wAISw/dao-choc-ble/pcb/56key/dao-choc-ble-pcb-right/dao-choc-ble-right.kicad_pcb

## KiCad design pcb/56key/dao-choc-ble-pcb-right/dao-choc-ble-right.kicad_pcb (2022-12-07)

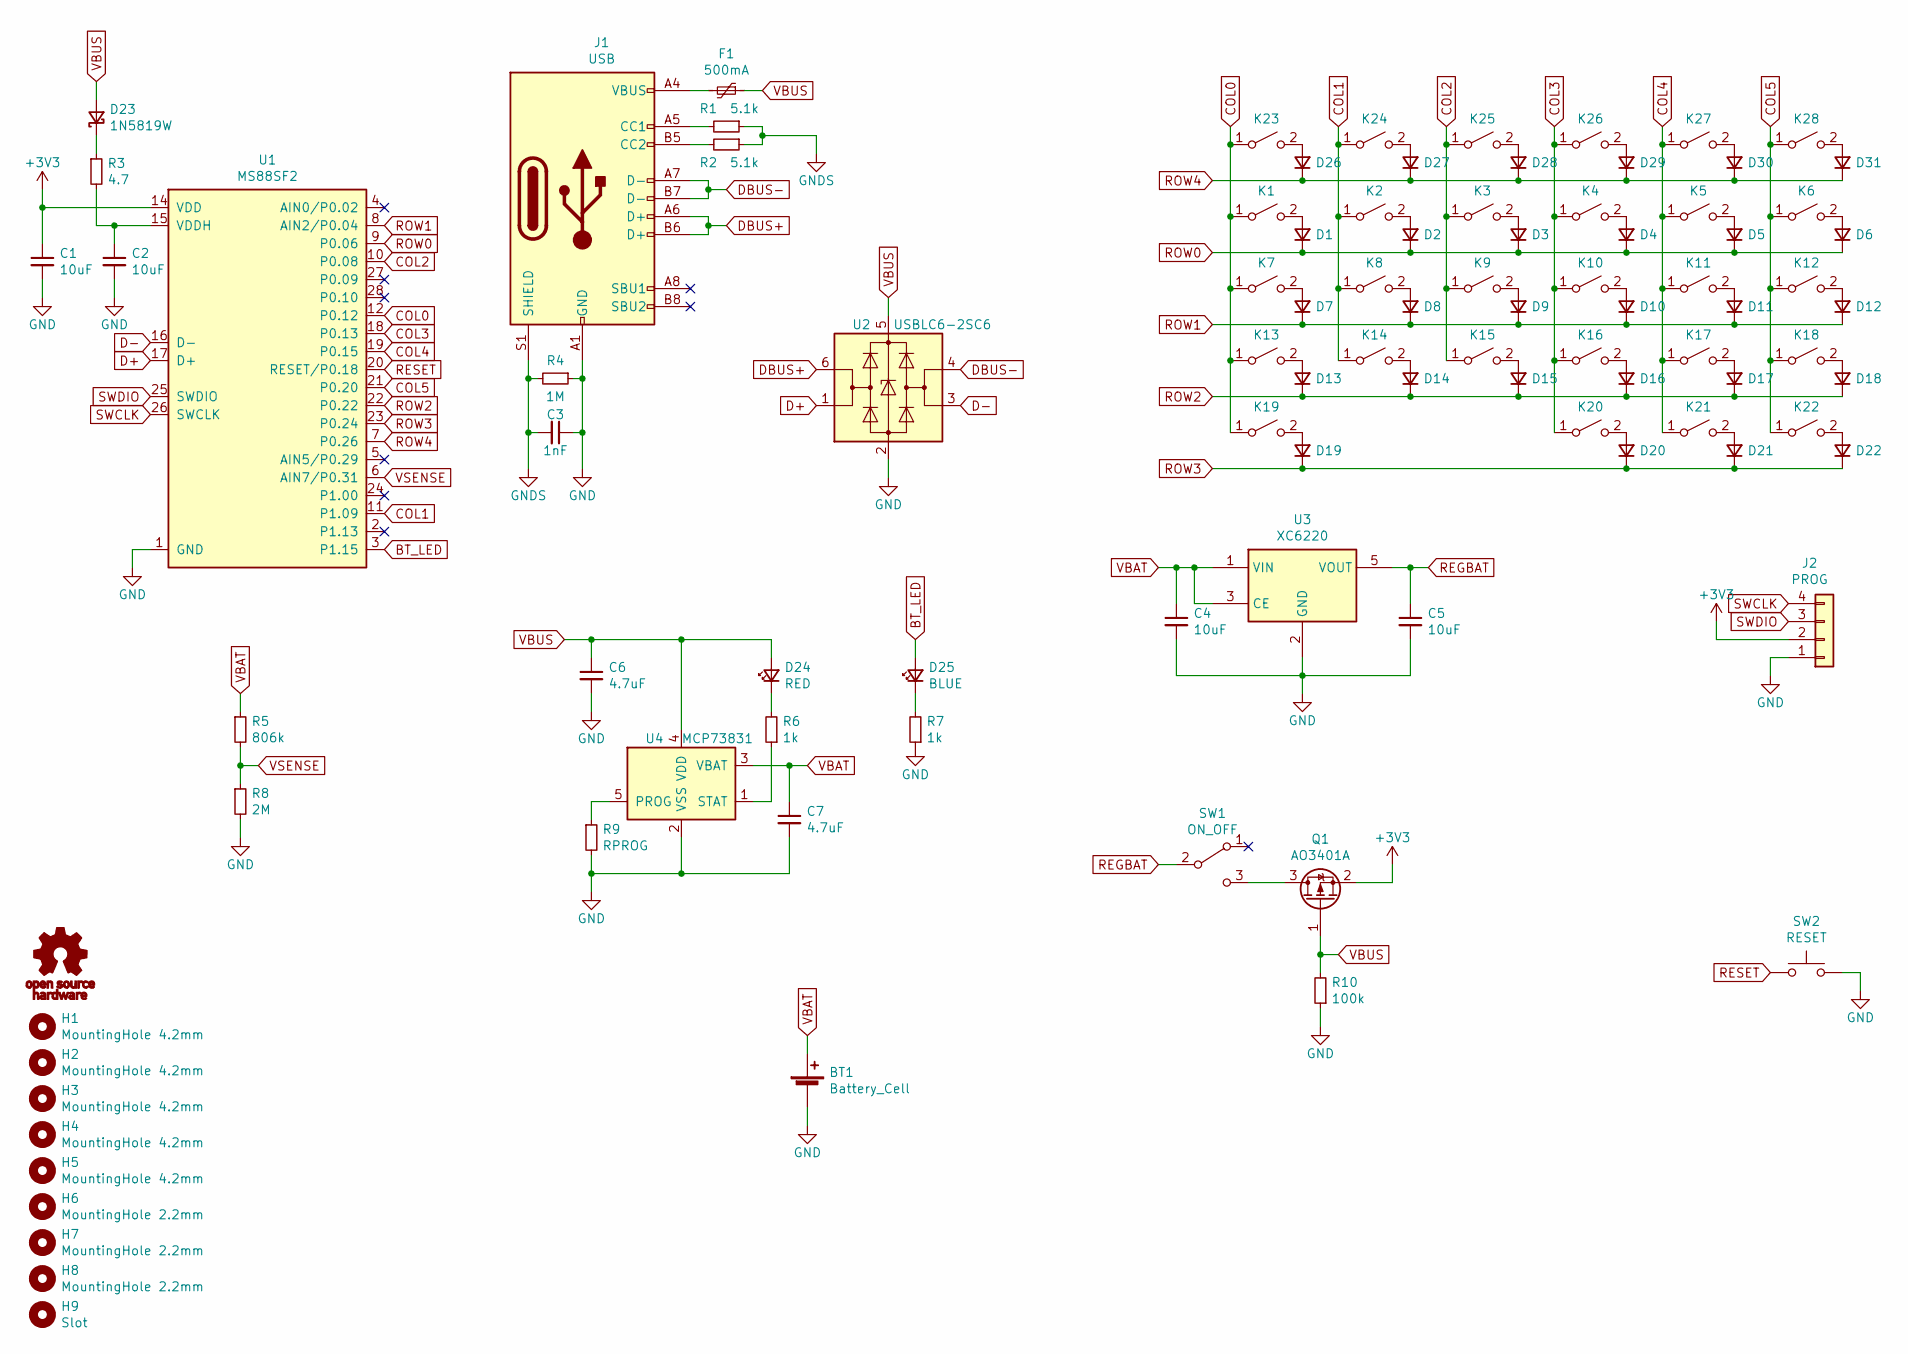
[picture p1: schematic dao-choc-ble-right.kicad_sch]

Parts:
BT1: Battery_Cell; Battery
C1, C2, C4, C5: 10uF; C_0603_1608Metric; LCSC C19702
C3: 1nF; C_0603_1608Metric; LCSC C1588
C6, C7: 4.7uF; C_0603_1608Metric; LCSC C19666
D1, D2, D3, D4, D5, D6, D7, D8, D9, D10, D11, D12, D13, D14, D15, D16, D17, D18, D19, D20, D21, D22, D26, D27, D28, D29, D30, D31: 1N4148WS; D_SOD-323; LCSC C57759
D23: 1N5819W; D_SOD-123; LCSC C169540
D24: RED; LED_0603_1608Metric; LCSC C2286
D25: BLUE; LED_0603_1608Metric; LCSC C72041
F1: 500mA; Fuse_1206_3216Metric; LCSC C355568
H1, H2, H3, H4, H5: MountingHole 4.2mm; Hole_4.2mm
H6, H7, H8: MountingHole 2.2mm; Hole_2.2mm
H9: Slot
J1: USB; USB-C_C168688; LCSC C168688
J2: PROG
K1, K2, K3, K4, K5, K6, K7, K8, K9, K10, K11, K12, K13, K14, K15, K16, K17, K18, K19, K20, K21, K22, K23, K24, K25, K26, K27, K28: KEY_SWITCH; Kailh_PG1350_hotswap
LOGO1: OSHW-logo
Q1: AO3401A; SOT-23; LCSC C15127
R1, R2: 5.1k; R_0603_1608Metric; LCSC C23186
R3: 4.7; R_0603_1608Metric; LCSC C23164
R4: 1M; R_0603_1608Metric; LCSC C22935
R5: 806k; R_0603_1608Metric; LCSC C103828
R6, R7: 1k; R_0603_1608Metric; LCSC C21190
R8: 2M; R_0603_1608Metric; LCSC C22976
R9: RPROG; R_0603_1608Metric; LCSC C22978
R10: 100k; R_0603_1608Metric; LCSC C25803
SW1: ON_OFF; MSK-12C02; LCSC C431541
SW2: RESET; TS-1086E; LCSC C455276
U1: MS88SF2; MINEW_MS88SF2
U2: USBLC6-2SC6; SOT-23-6; LCSC C558442
U3: XC6220; SOT-23-5; LCSC C86534
U4: MCP73831; SOT-23-5; LCSC C14879

Connections:
+3V3: C1.1, J2.2, Q1.2 (S), U1.14 (VDD)
BT_LED: D25.2 (A), U1.3 (P1.15)
COL0: K1.1 (A), K7.1 (A), K13.1 (A), K19.1 (A), K23.1 (A), U1.12 (P0.12)
COL1: K2.1 (A), K8.1 (A), K14.1 (A), K24.1 (A), U1.11 (P1.09)
COL2: K3.1 (A), K9.1 (A), K15.1 (A), K25.1 (A), U1.10 (P0.08)
COL3: K4.1 (A), K10.1 (A), K16.1 (A), K20.1 (A), K26.1 (A), U1.18 (P0.13)
COL4: K5.1 (A), K11.1 (A), K17.1 (A), K21.1 (A), K27.1 (A), U1.19 (P0.15)
COL5: K6.1 (A), K12.1 (A), K18.1 (A), K22.1 (A), K28.1 (A), U1.21 (P0.20)
D+: U1.17 (D+), U2.1 (I/O1)
D-: U1.16 (D-), U2.3 (I/O2)
DBUS+: J1.A6 (D+), J1.B6 (D+), U2.6 (I/O1)
DBUS-: J1.A7 (D-), J1.B7 (D-), U2.4 (I/O2)
GND: BT1.2 (-), C1.2, C2.2, C3.1, C4.2, C5.2, C6.2, C7.2, J1.A1 (GND), J1.A12 (GND), J1.B1 (GND), J1.B12 (GND), J2.1, R4.1, R7.1, R8.2, R9.2, R10.1, SW2.2, U1.1 (GND), U1.13 (GND), U2.2 (GND), U3.2 (GND), U4.2 (VSS)
GNDS: C3.2, J1.S1 (SHIELD), R1.1, R2.1, R4.2
unnamed: C2.1, R3.2, U1.15 (VDDH)
unnamed: D1.2 (A), K1.2 (B)
unnamed: D2.2 (A), K2.2 (B)
unnamed: D3.2 (A), K3.2 (B)
unnamed: D4.2 (A), K4.2 (B)
unnamed: D5.2 (A), K5.2 (B)
unnamed: D6.2 (A), K6.2 (B)
unnamed: D7.2 (A), K7.2 (B)
unnamed: D8.2 (A), K8.2 (B)
unnamed: D9.2 (A), K9.2 (B)
unnamed: D10.2 (A), K10.2 (B)
unnamed: D11.2 (A), K11.2 (B)
unnamed: D12.2 (A), K12.2 (B)
unnamed: D13.2 (A), K13.2 (B)
unnamed: D14.2 (A), K14.2 (B)
unnamed: D15.2 (A), K15.2 (B)
unnamed: D16.2 (A), K16.2 (B)
unnamed: D17.2 (A), K17.2 (B)
unnamed: D18.2 (A), K18.2 (B)
unnamed: D19.2 (A), K19.2 (B)
unnamed: D20.2 (A), K20.2 (B)
unnamed: D21.2 (A), K21.2 (B)
unnamed: D22.2 (A), K22.2 (B)
unnamed: D23.1 (K), R3.1
unnamed: D24.1 (K), R6.2
unnamed: D25.1 (K), R7.2
unnamed: F1.2, J1.A4 (VBUS), J1.A9 (VBUS), J1.B4 (VBUS), J1.B9 (VBUS)
unnamed: J1.A5 (CC1), R1.2
unnamed: J1.B5 (CC2), R2.2
unnamed: D26.2 (A), K23.2 (B)
unnamed: D27.2 (A), K24.2 (B)
unnamed: D28.2 (A), K25.2 (B)
unnamed: D29.2 (A), K26.2 (B)
unnamed: D30.2 (A), K27.2 (B)
unnamed: D31.2 (A), K28.2 (B)
unnamed: Q1.3 (D), SW1.3 (C)
unnamed: R6.1, U4.1 (STAT)
unnamed: R9.1, U4.5 (PROG)
REGBAT: C5.1, SW1.2 (B), U3.5 (VOUT)
RESET: SW2.1, U1.20 (RESET/P0.18)
ROW0: D1.1 (K), D2.1 (K), D3.1 (K), D4.1 (K), D5.1 (K), D6.1 (K), U1.9 (P0.06)
ROW1: D7.1 (K), D8.1 (K), D9.1 (K), D10.1 (K), D11.1 (K), D12.1 (K), U1.8 (AIN2/P0.04)
ROW2: D13.1 (K), D14.1 (K), D15.1 (K), D16.1 (K), D17.1 (K), D18.1 (K), U1.22 (P0.22)
ROW3: D19.1 (K), D20.1 (K), D21.1 (K), D22.1 (K), U1.23 (P0.24)
ROW4: D26.1 (K), D27.1 (K), D28.1 (K), D29.1 (K), D30.1 (K), D31.1 (K), U1.7 (P0.26)
SWCLK: J2.4, U1.26 (SWCLK)
SWDIO: J2.3, U1.25 (SWDIO)
VBAT: BT1.1 (+), C4.1, C7.1, R5.1, U3.1 (VIN), U3.3 (CE), U4.3 (VBAT)
VBUS: C6.1, D23.2 (A), D24.2 (A), F1.1, Q1.1 (G), R10.2, U2.5 (VBUS), U4.4 (VDD)
VSENSE: R5.2, R8.1, U1.6 (AIN7/P0.31)

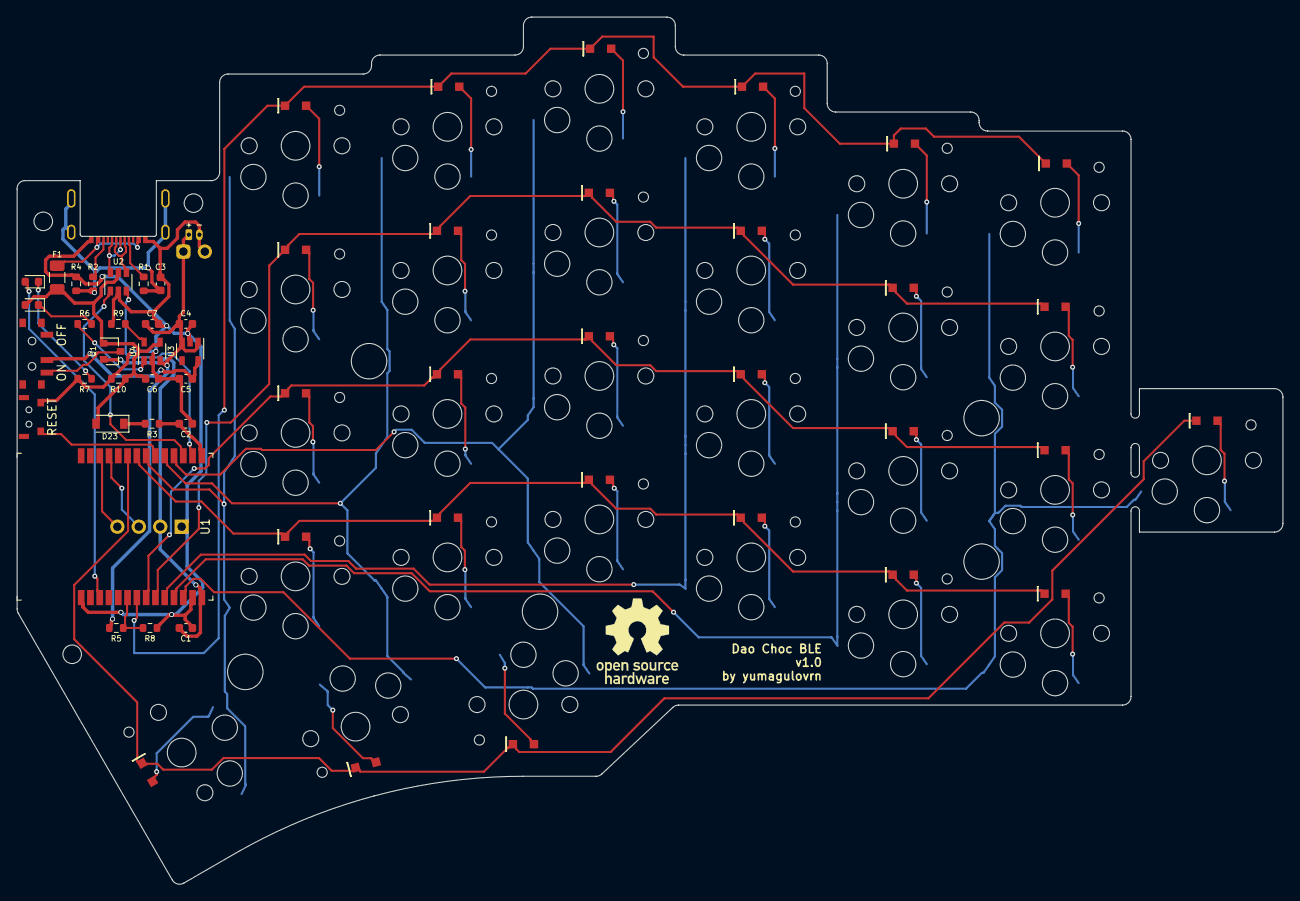
[picture p2: board dao-choc-ble-right.kicad_pcb from above]

Board: 2 copper layers, 150.0 x 102.8 mm, 97 parts (1 on the bottom side), 64 nets.
