wAISw/dao-choc-ble/(commit log)

2022-12-01 First iteration of 56 key left side.
    [dao-choc-ble-left.csv, dao-choc-ble-left.kicad_pcb, dao-choc-ble-left.kicad_sch, dao-choc-ble-right.kicad_pcb, dao-choc-ble-right.kicad_sch]
2022-12-06 Fixed errors.
    [dao-choc-ble-left.kicad_pcb, dao-choc-ble-left.kicad_sch]
2022-12-07 Updated right side.
    [dao-choc-ble-right.kicad_pcb, dao-choc-ble-right.kicad_sch]
2022-12-10 Created top plate.
    [dao-choc-ble-plate.kicad_pcb]
