wAISw/dao-choc-ble/(notices)

Notices in the files:
pcb/56key/dao-choc-ble-pcb-left/dao-choc-ble-left.kicad_pcb:
Copyright (c) 2021
Licensed under CERN-OHL-P v2
